leak-guard/hardware/leakguard.kicad_pcb

## KiCad design leakguard.kicad_pcb (2024-10-15)

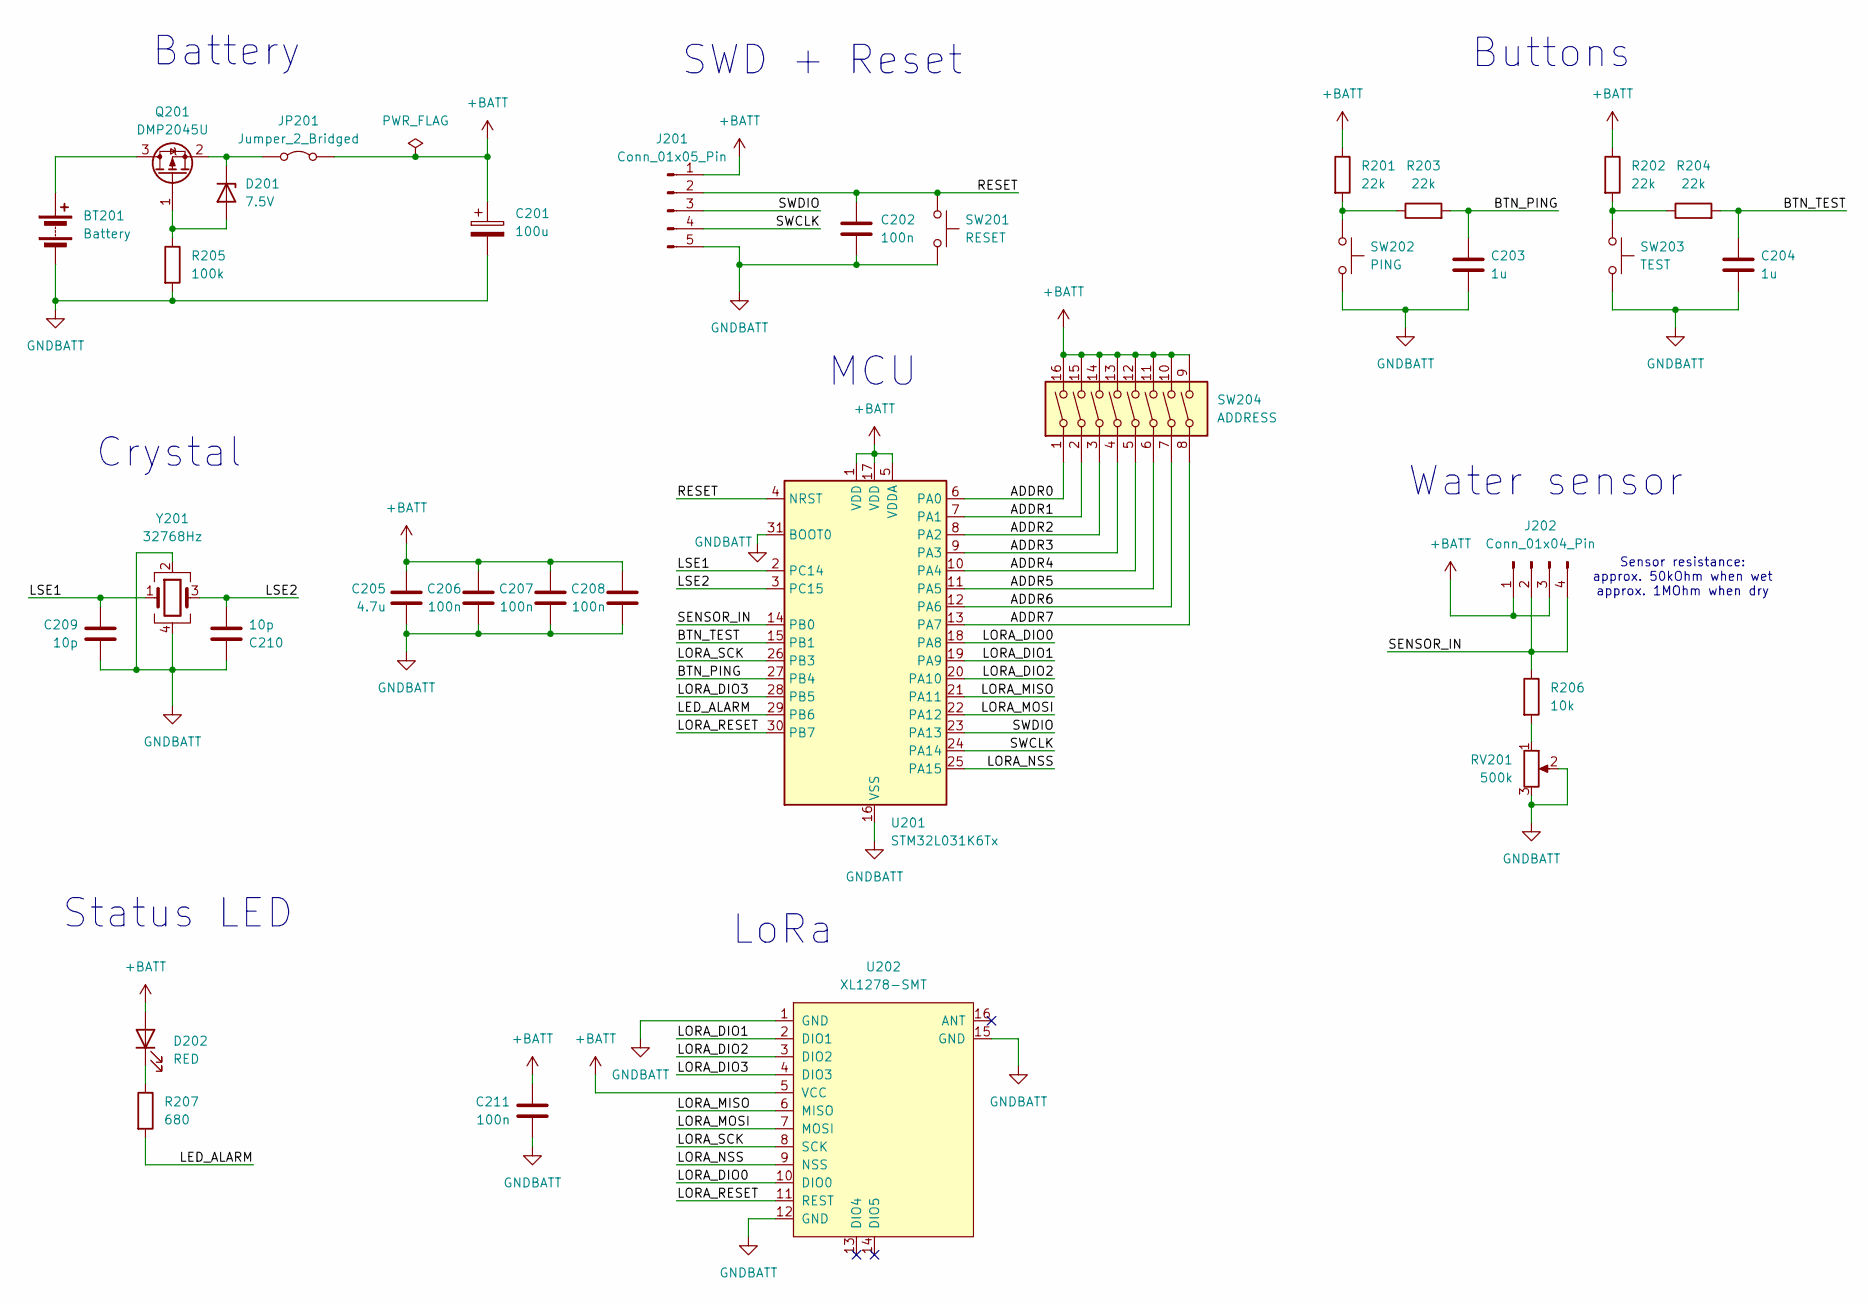
[picture p1: schematic sensor.kicad_sch, LeakGuard Sensor Unit]

Parts:
BT201: Battery; PinSocket_1x02_P2.54mm_Vertical
C201: 100u; CP_Radial_D5.0mm_P2.00mm
C202, C206, C207, C208, C211: 100n; C_0805_2012Metric_Pad1.18x1.45mm_HandSolder
C203, C204: 1u; C_0805_2012Metric_Pad1.18x1.45mm_HandSolder
C205: 4.7u; C_0805_2012Metric_Pad1.18x1.45mm_HandSolder
C209, C210: 10p; C_0805_2012Metric_Pad1.18x1.45mm_HandSolder
D201: 7.5V; D_SOD-523
D202: RED; LED_0805_2012Metric_Pad1.15x1.40mm_HandSolder
J201: Conn_01x05_Pin; PinHeader_1x05_P2.54mm_Vertical
J202: Conn_01x04_Pin; PinHeader_1x04_P2.54mm_Horizontal
JP201: Jumper_2_Bridged; PinHeader_1x02_P2.54mm_Horizontal
Q201: DMP2045U; SOT-23
R201, R202, R203, R204: 22k; R_0805_2012Metric_Pad1.20x1.40mm_HandSolder
R205: 100k; R_0805_2012Metric_Pad1.20x1.40mm_HandSolder
R206: 10k; R_0805_2012Metric_Pad1.20x1.40mm_HandSolder
R207: 680; R_0805_2012Metric_Pad1.20x1.40mm_HandSolder
RV201: 500k; Potentiometer_Piher_PT-6-V_Vertical
SW201: RESET; SW_Push_1P1T_NO_6x6mm_H9.5mm
SW202: PING; SW_Push_1P1T_NO_6x6mm_H9.5mm
SW203: TEST; SW_Push_1P1T_NO_6x6mm_H9.5mm
SW204: ADDRESS; SW_DIP_SPSTx08_Slide_9.78x22.5mm_W7.62mm_P2.54mm
U201: STM32L031K6Tx; LQFP-32_7x7mm_P0.8mm
U202: XL1278-SMT
Y201: 32768Hz; Oscillator_SMD_Abracon_ASDMB-4Pin_2.5x2.0mm

Connections:
+BATT: C201.1, C205.1, C206.1, C207.1, C208.1, C211.1, D202.2 (A), J201.1, J202.1, J202.3, JP201.2 (B), R201.1, R202.1, SW204.9, SW204.10, SW204.11, SW204.12, SW204.13, SW204.14, SW204.15, SW204.16, U201.1 (VDD), U201.5 (VDDA), U201.17 (VDD), U202.5 (VCC)
/Sensor unit/ADDR0: SW204.1, U201.6 (PA0)
/Sensor unit/ADDR1: SW204.2, U201.7 (PA1)
/Sensor unit/ADDR2: SW204.3, U201.8 (PA2)
/Sensor unit/ADDR3: SW204.4, U201.9 (PA3)
/Sensor unit/ADDR4: SW204.5, U201.10 (PA4)
/Sensor unit/ADDR5: SW204.6, U201.11 (PA5)
/Sensor unit/ADDR6: SW204.7, U201.12 (PA6)
/Sensor unit/ADDR7: SW204.8, U201.13 (PA7)
/Sensor unit/BTN_PING: C203.1, R203.2, U201.27 (PB4)
/Sensor unit/BTN_TEST: C204.1, R204.2, U201.15 (PB1)
/Sensor unit/LED_ALARM: R207.2, U201.29 (PB6)
/Sensor unit/LORA_DIO0: U201.18 (PA8), U202.10 (DIO0)
/Sensor unit/LORA_DIO1: U201.19 (PA9), U202.2 (DIO1)
/Sensor unit/LORA_DIO2: U201.20 (PA10), U202.3 (DIO2)
/Sensor unit/LORA_DIO3: U201.28 (PB5), U202.4 (DIO3)
/Sensor unit/LORA_MISO: U201.21 (PA11), U202.6 (MISO)
/Sensor unit/LORA_MOSI: U201.22 (PA12), U202.7 (MOSI)
/Sensor unit/LORA_NSS: U201.25 (PA15), U202.9 (NSS)
/Sensor unit/LORA_RESET: U201.30 (PB7), U202.11 (REST)
/Sensor unit/LORA_SCK: U201.26 (PB3), U202.8 (SCK)
/Sensor unit/LSE1: C209.1, U201.2 (PC14), Y201.1
/Sensor unit/LSE2: C210.2, U201.3 (PC15), Y201.3
/Sensor unit/RESET: C202.1, J201.2, SW201.1, U201.4 (NRST)
/Sensor unit/SENSOR_IN: J202.2, J202.4, R206.1, U201.14 (PB0)
/Sensor unit/SWCLK: J201.4, U201.24 (PA14)
/Sensor unit/SWDIO: J201.3, U201.23 (PA13)
GNDBATT: BT201.2 (-), C201.2, C202.2, C203.2, C204.2, C205.2, C206.2, C207.2, C208.2, C209.2, C210.1, C211.2, J201.5, R205.2, RV201.2, RV201.3, SW201.2, SW202.2, SW203.2, U201.16 (VSS), U201.31 (BOOT0), U201.32 (VSS), U202.1 (GND), U202.12 (GND), U202.15 (GND), Y201.2, Y201.4
unnamed: BT201.1 (+), Q201.3 (D)
unnamed: D201.2 (A), Q201.1 (G), R205.1
unnamed: D201.1 (K), JP201.1 (A), Q201.2 (S)
unnamed: D202.1 (K), R207.1
unnamed: R201.2, R203.1, SW202.1
unnamed: R202.2, R204.1, SW203.1
unnamed: R206.2, RV201.1

Notes on the sheet:
Battery
Water sensor
Buttons
Sensor resistance: approx. 50kOhm when wet approx. 1MOhm when dry
Status LED
SWD + Reset
LoRa
MCU
Crystal

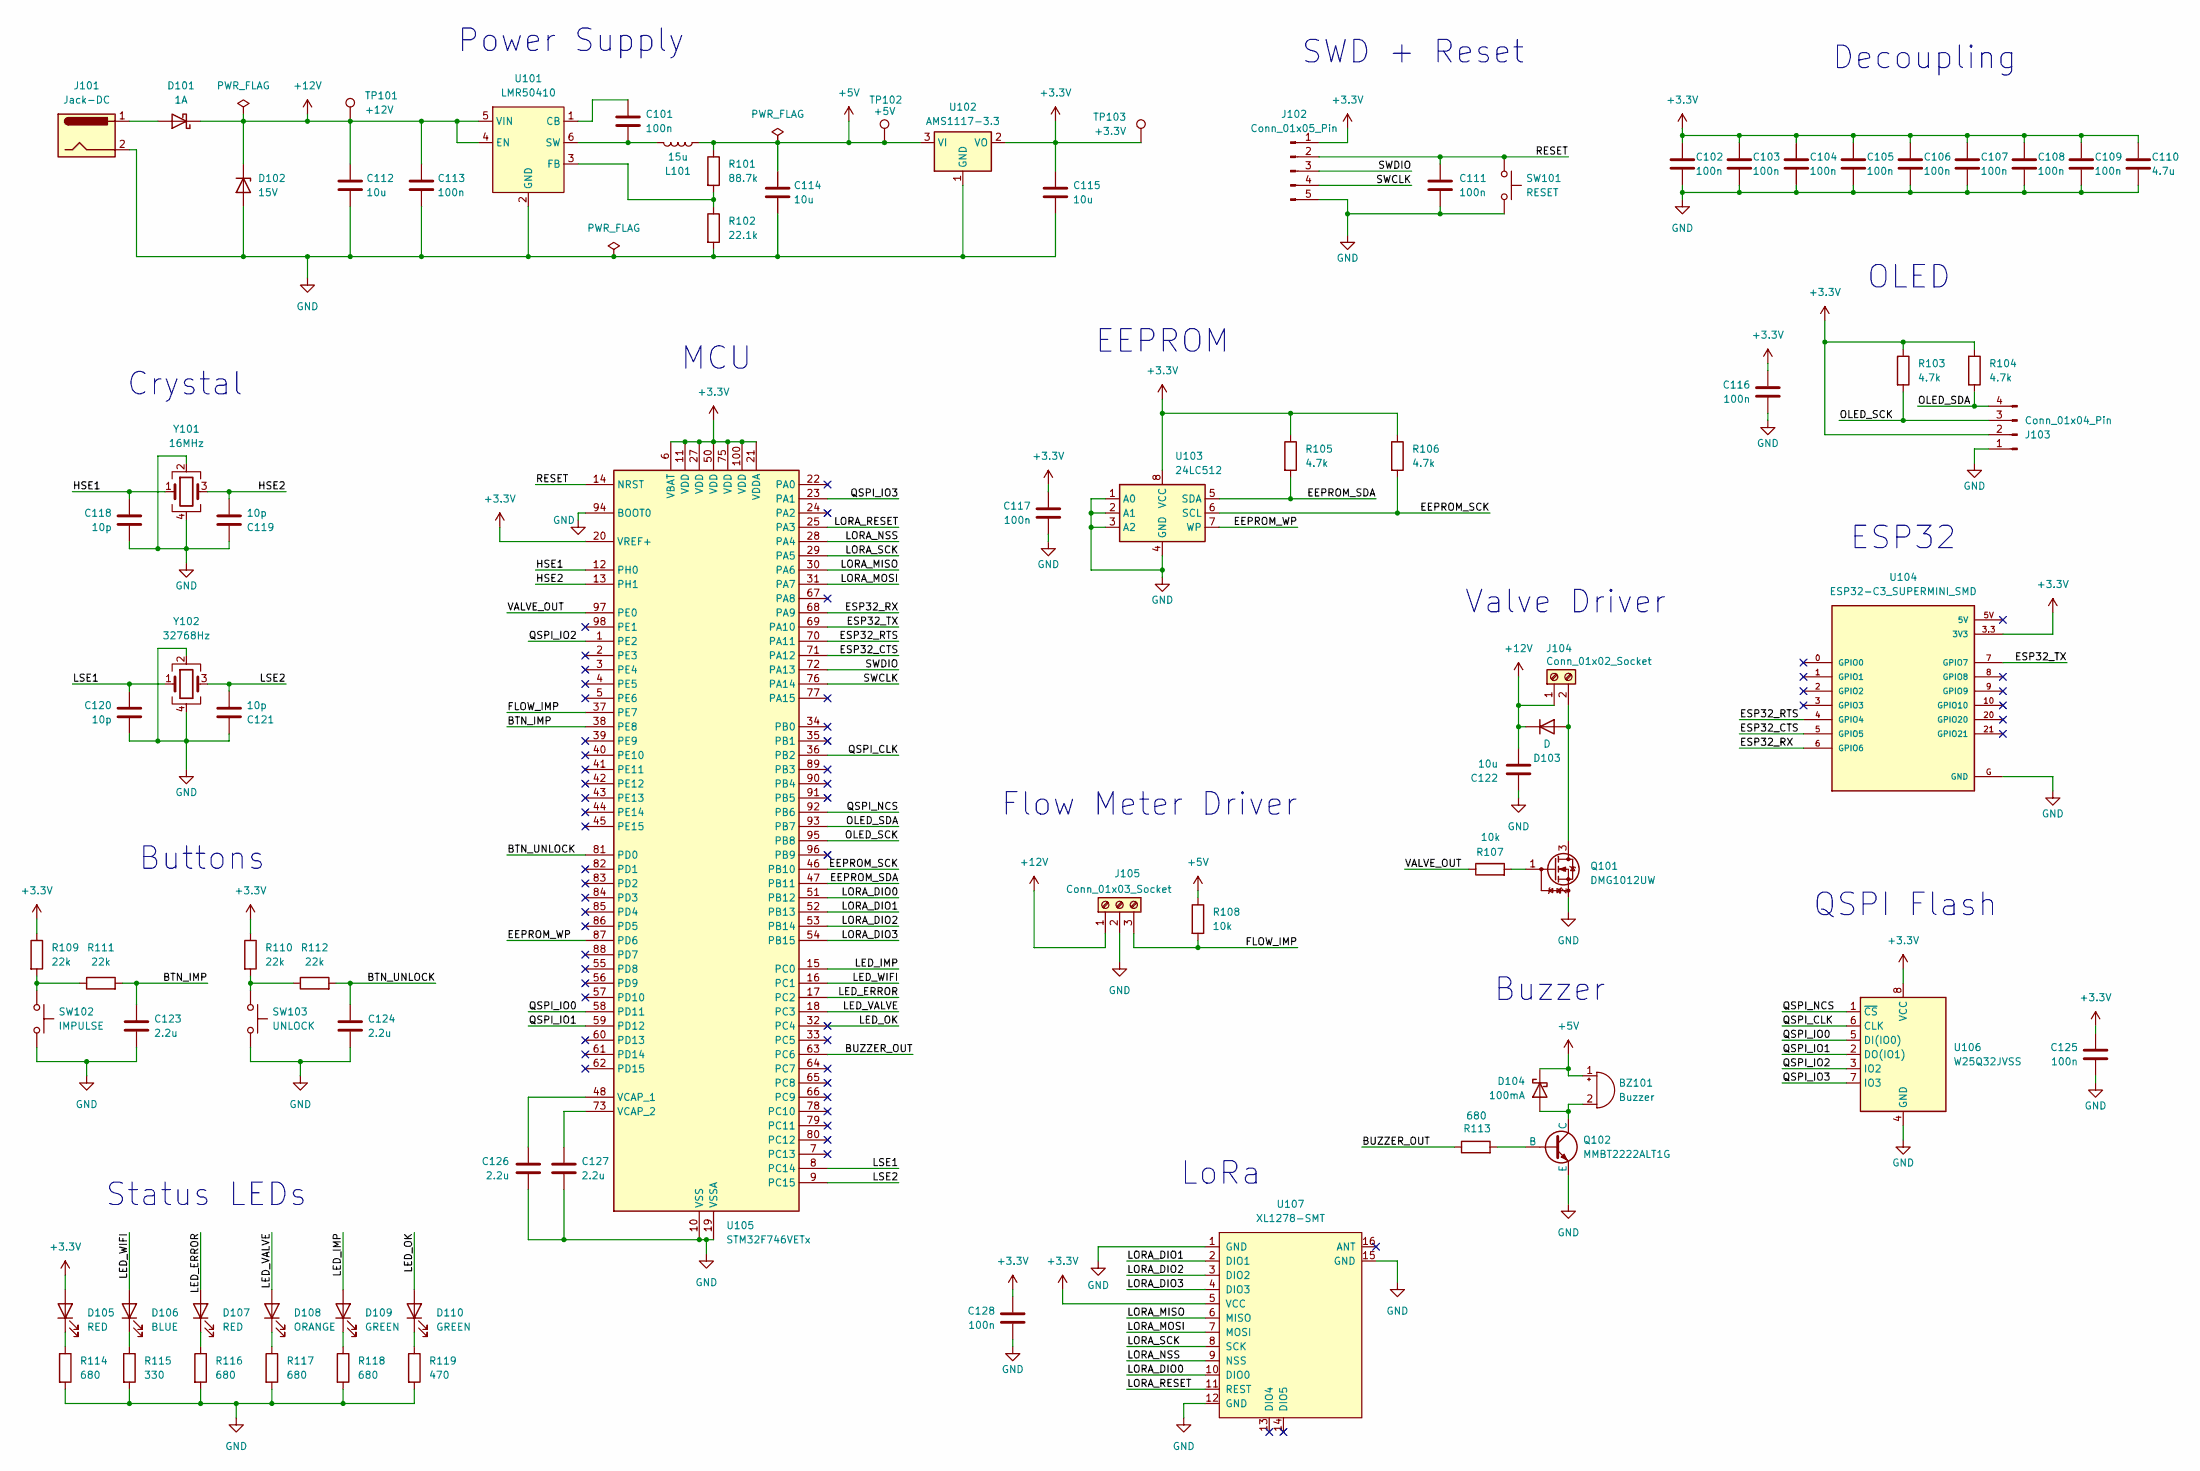
[picture p2: schematic main.kicad_sch, LeakGuard Main Unit]

Parts:
BZ101: Buzzer; Buzzer_TDK_PS1240P02BT_D12.2mm_H6.5mm
C101, C102, C103, C104, C105, C106, C107, C108, C109, C111, C113, C116, C117, C125, C128: 100n; C_0805_2012Metric_Pad1.18x1.45mm_HandSolder
C110: 4.7u; C_0805_2012Metric_Pad1.18x1.45mm_HandSolder
C112, C114, C115, C122: 10u; C_0805_2012Metric_Pad1.18x1.45mm_HandSolder
C118, C119, C120, C121: 10p; C_0805_2012Metric_Pad1.18x1.45mm_HandSolder
C123, C124, C126, C127: 2.2u; C_0805_2012Metric_Pad1.18x1.45mm_HandSolder
D101: 1A; D_SOD-123
D102: 15V; D_PowerDI-123
D103: D; D_SOD-123
D104: 100mA; D_SOD-123
D105, D107: RED; LED_D3.0mm
D106: BLUE; LED_D3.0mm
D108: ORANGE; LED_D3.0mm
D109: GREEN; LED_0805_2012Metric_Pad1.15x1.40mm_HandSolder
D110: GREEN; LED_D3.0mm
J101: Jack-DC; BarrelJack_CUI_PJ-036AH-SMT_Horizontal
J102: Conn_01x05_Pin; PinHeader_1x05_P2.54mm_Vertical
J103: Conn_01x04_Pin; PinHeader_1x04_P2.54mm_Vertical
J104: Conn_01x02_Socket; TerminalBlock_4Ucon_1x02_P3.50mm_Horizontal
J105: Conn_01x03_Socket; TerminalBlock_4Ucon_1x03_P3.50mm_Horizontal
L101: 15u; L_Vishay_IHLP-1616
Q101: DMG1012UW; SOT-323_SC-70
Q102: MMBT2222ALT1G; SOT-23-3
R101: 88.7k; R_0805_2012Metric_Pad1.20x1.40mm_HandSolder
R102: 22.1k; R_0805_2012Metric_Pad1.20x1.40mm_HandSolder
R103, R104, R105, R106: 4.7k; R_0805_2012Metric_Pad1.20x1.40mm_HandSolder
R107, R108: 10k; R_0805_2012Metric_Pad1.20x1.40mm_HandSolder
R109, R110, R111, R112: 22k; R_0805_2012Metric_Pad1.20x1.40mm_HandSolder
R113, R114, R116, R117, R118: 680; R_0805_2012Metric_Pad1.20x1.40mm_HandSolder
R115: 330; R_0805_2012Metric_Pad1.20x1.40mm_HandSolder
R119: 470; R_0805_2012Metric_Pad1.20x1.40mm_HandSolder
SW101: RESET; SW_Push_1P1T_NO_6x6mm_H9.5mm
SW102: IMPULSE; SW_Push_1P1T_NO_6x6mm_H9.5mm
SW103: UNLOCK; SW_Push_1P1T_NO_6x6mm_H9.5mm
TP101: +12V; TestPoint_Pad_D1.5mm
TP102: +5V; TestPoint_Pad_D1.5mm
TP103: +3.3V; TestPoint_Pad_D1.5mm
U101: LMR50410; SOT-23-6_Handsoldering
U102: AMS1117-3.3; SOT-223-3_TabPin2
U103: 24LC512; SOIC-8_3.9x4.9mm_P1.27mm
U104: ESP32-C3_SUPERMINI_SMD; MODULE_ESP32-C3_SUPERMINI
U105: STM32F746VETx; LQFP-100_14x14mm_P0.5mm
U106: W25Q32JVSS; SOIC-8_5.23x5.23mm_P1.27mm
U107: XL1278-SMT
Y101: 16MHz; Oscillator_SMD_Abracon_ASDMB-4Pin_2.5x2.0mm
Y102: 32768Hz; Oscillator_SMD_Abracon_ASDMB-4Pin_2.5x2.0mm

Connections:
+3.3V: C102.1, C103.1, C104.1, C105.1, C106.1, C107.1, C108.1, C109.1, C110.1, C115.1, C116.1, C117.1, C125.1, C128.1, D105.2 (A), J102.1, J103.2, R103.1, R104.1, R105.1, R106.1, R109.1, R110.1, TP103.1, U102.2 (VO), U103.8 (VCC), U104.3.3 (3V3), U105.6 (VBAT), U105.11 (VDD), U105.20 (VREF+), U105.21 (VDDA), U105.27 (VDD), U105.50 (VDD), U105.75 (VDD), U105.100 (VDD), U106.8 (VCC), U107.5 (VCC)
+5V: BZ101.1 (+), C114.1, D104.1 (K), L101.2, R101.1, R108.1, TP102.1, U102.3 (VI)
+12V: C112.1, C113.1, C122.2, D101.1 (K), D102.1 (K), D103.1 (K), J104.1, J105.1, TP101.1, U101.4 (EN), U101.5 (VIN)
/Main unit/BTN_IMP: C123.1, R111.2, U105.38 (PE8)
/Main unit/BTN_UNLOCK: C124.1, R112.2, U105.81 (PD0)
/Main unit/BUZZER_OUT: R113.1, U105.63 (PC6)
/Main unit/EEPROM_SCK: R106.2, U103.6 (SCL), U105.46 (PB10)
/Main unit/EEPROM_SDA: R105.2, U103.5 (SDA), U105.47 (PB11)
/Main unit/EEPROM_WP: U103.7 (WP), U105.87 (PD6)
/Main unit/ESP32_CTS: U104.5 (GPIO5), U105.71 (PA12)
/Main unit/ESP32_RTS: U104.4 (GPIO4), U105.70 (PA11)
/Main unit/ESP32_RX: U104.6 (GPIO6), U105.68 (PA9)
/Main unit/ESP32_TX: U104.7 (GPIO7), U105.69 (PA10)
/Main unit/FLOW_IMP: J105.3, R108.2, U105.37 (PE7)
/Main unit/HSE1: C118.1, U105.12 (PH0), Y101.1
/Main unit/HSE2: C119.2, U105.13 (PH1), Y101.3
/Main unit/LED_ERROR: D107.2 (A), U105.17 (PC2)
/Main unit/LED_IMP: D109.2 (A), U105.15 (PC0)
/Main unit/LED_OK: D110.2 (A), U105.32 (PC4)
/Main unit/LED_VALVE: D108.2 (A), U105.18 (PC3)
/Main unit/LED_WIFI: D106.2 (A), U105.16 (PC1)
/Main unit/LORA_DIO0: U105.51 (PB12), U107.10 (DIO0)
/Main unit/LORA_DIO1: U105.52 (PB13), U107.2 (DIO1)
/Main unit/LORA_DIO2: U105.53 (PB14), U107.3 (DIO2)
/Main unit/LORA_DIO3: U105.54 (PB15), U107.4 (DIO3)
/Main unit/LORA_MISO: U105.30 (PA6), U107.6 (MISO)
/Main unit/LORA_MOSI: U105.31 (PA7), U107.7 (MOSI)
/Main unit/LORA_NSS: U105.28 (PA4), U107.9 (NSS)
/Main unit/LORA_RESET: U105.25 (PA3), U107.11 (REST)
/Main unit/LORA_SCK: U105.29 (PA5), U107.8 (SCK)
/Main unit/LSE1: C120.1, U105.8 (PC14), Y102.1
/Main unit/LSE2: C121.2, U105.9 (PC15), Y102.3
/Main unit/OLED_SCK: J103.3, R103.2, U105.95 (PB8)
/Main unit/OLED_SDA: J103.4, R104.2, U105.93 (PB7)
/Main unit/QSPI_CLK: U105.36 (PB2), U106.6 (CLK)
/Main unit/QSPI_IO0: U105.58 (PD11), U106.5 (DI(IO0))
/Main unit/QSPI_IO1: U105.59 (PD12), U106.2 (DO(IO1))
/Main unit/QSPI_IO2: U105.1 (PE2), U106.3 (IO2)
/Main unit/QSPI_IO3: U105.23 (PA1), U106.7 (IO3)
/Main unit/QSPI_NCS: U105.92 (PB6), U106.1 (~CS)
/Main unit/RESET: C111.1, J102.2, SW101.1, U105.14 (NRST)
/Main unit/SWCLK: J102.4, U105.76 (PA14)
/Main unit/SWDIO: J102.3, U105.72 (PA13)
/Main unit/VALVE_OUT: R107.1, U105.97 (PE0)
GND: C102.2, C103.2, C104.2, C105.2, C106.2, C107.2, C108.2, C109.2, C110.2, C111.2, C112.2, C113.2, C114.2, C115.2, C116.2, C117.2, C118.2, C119.1, C120.2, C121.1, C122.1, C123.2, C124.2, C125.2, C126.2, C127.2, C128.2, D102.2 (A), J101.2, J102.5, J103.1, J105.2, Q101.2 (S), Q102.3 (E), R102.2, R114.2, R115.2, R116.2, R117.2, R118.2, R119.2, SW101.2, SW102.2, SW103.2, U101.2 (GND), U102.1 (GND), U103.1 (A0), U103.2 (A1), U103.3 (A2), U103.4 (GND), U104.G (GND), U105.10 (VSS), U105.19 (VSSA), U105.26 (VSS), U105.49 (VSS), U105.74 (VSS), U105.94 (BOOT0), U105.99 (VSS), U106.4 (GND), U107.1 (GND), U107.12 (GND), U107.15 (GND), Y101.2, Y101.4, Y102.2, Y102.4
unnamed: BZ101.2 (-), D104.2 (A), Q102.1 (C)
unnamed: D101.2 (A), J101.1
unnamed: D103.2 (A), J104.2, Q101.3 (D)
unnamed: D105.1 (K), R114.1
unnamed: D106.1 (K), R115.1
unnamed: D107.1 (K), R116.1
unnamed: D108.1 (K), R117.1
unnamed: D109.1 (K), R118.1
unnamed: D110.1 (K), R119.1
unnamed: Q101.1 (G), R107.2
unnamed: Q102.2 (B), R113.2
unnamed: R109.2, R111.1, SW102.1
unnamed: R110.2, R112.1, SW103.1
unnamed: C101.1, U101.1 (CB)
unnamed: R101.2, R102.1, U101.3 (FB)
unnamed: C101.2, L101.1, U101.6 (SW)
unnamed: C126.1, U105.48 (VCAP_1)
unnamed: C127.1, U105.73 (VCAP_2)

Notes on the sheet:
Flow Meter Driver
QSPI Flash
SWD + Reset
Valve Driver
Buttons
Power Supply
Decoupling
LoRa
EEPROM
MCU
Buzzer
ESP32
Crystal
Status LEDs
OLED

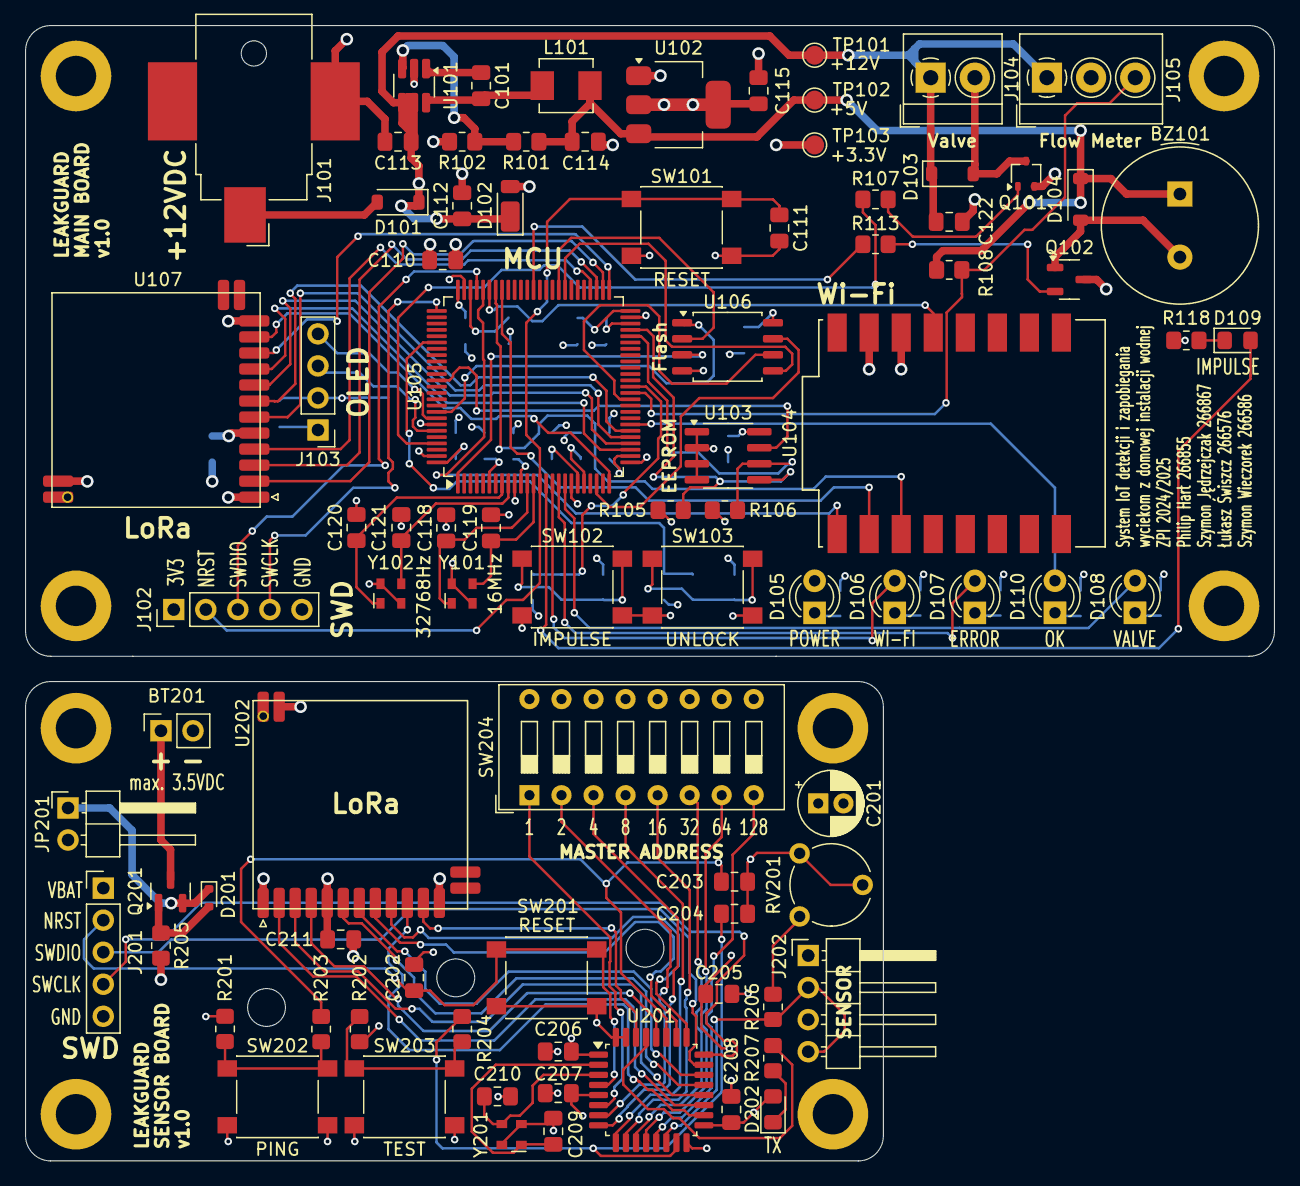
[picture p3: board leakguard.kicad_pcb from above]

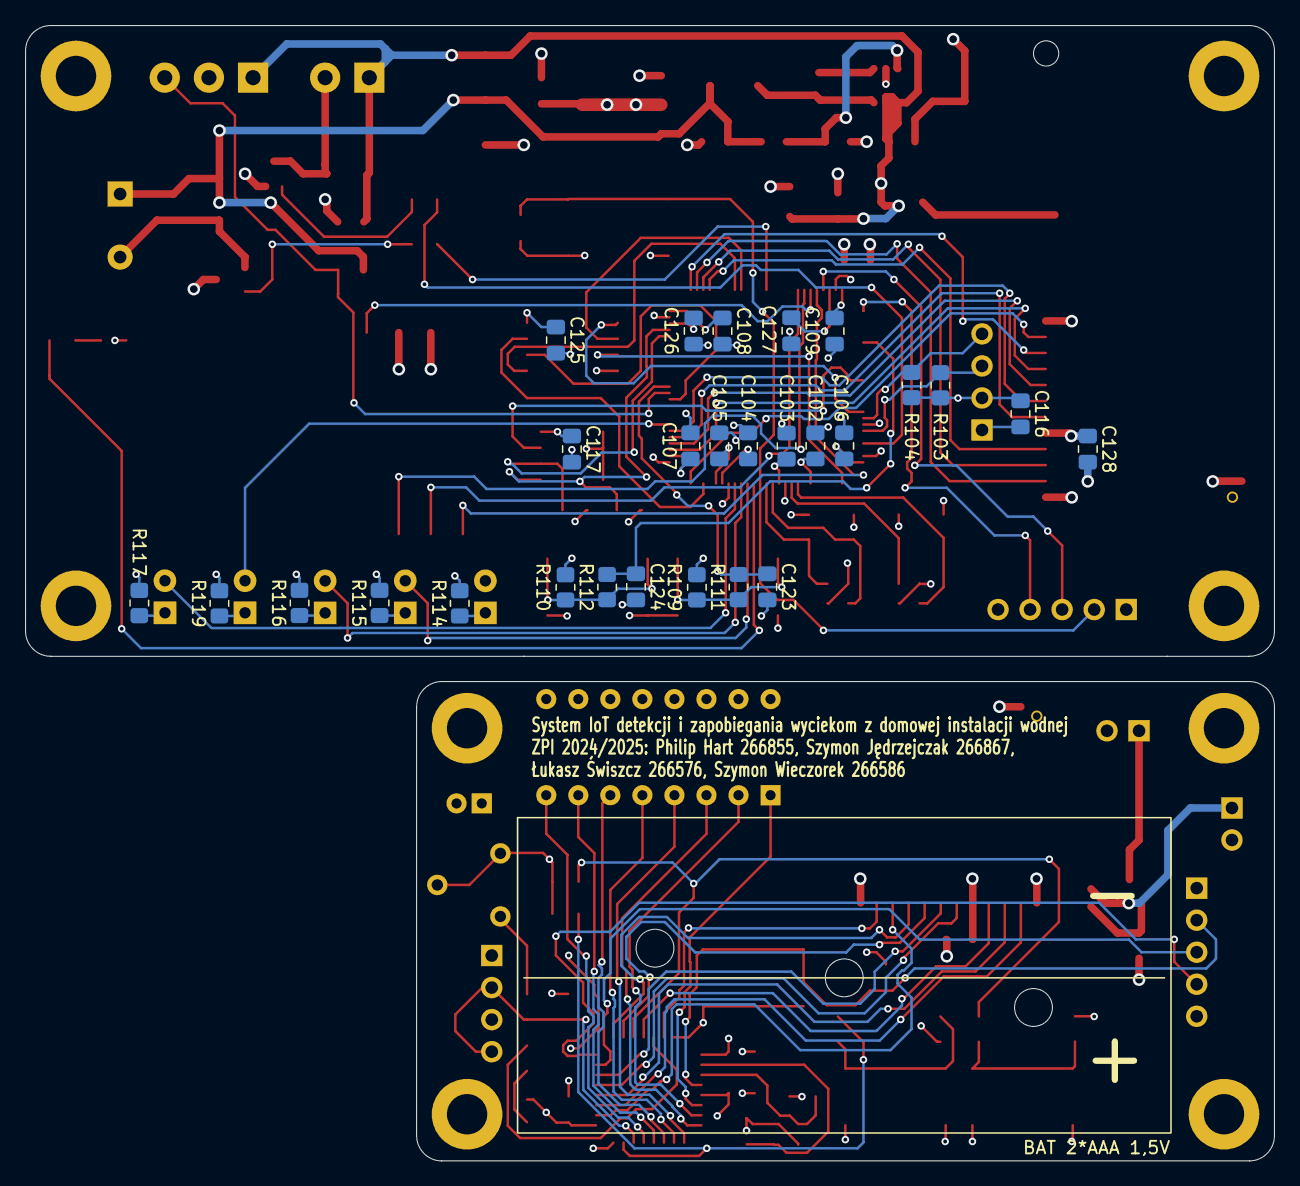
[picture p4: board leakguard.kicad_pcb from below]

Board: 4 copper layers, 99.0 x 90.0 mm, 115 parts (28 on the bottom side), 98 nets.

Other parts of the board:
BAT 2*AAA 1,5V: BatteryHolder
