leak-guard/hardware/(commit log)

2024-10-13 Upload first version of the HW project
    [leakguard.kicad_pcb, leakguard.kicad_sch, main.kicad_sch, sensor.kicad_sch]
2024-10-15 Final version sent to production
    [leakguard.kicad_pcb, main.kicad_pcb, main.kicad_sch, sensor.kicad_pcb, sensor.kicad_sch]
